carrola1/RasPi_NFC_Audio_PCB/RasPi Zero Pic.jpg

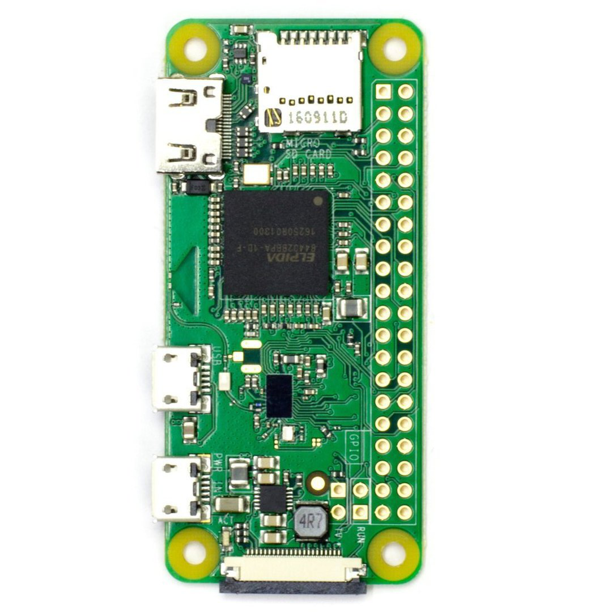
RasPi Zero Pic.jpg
