carrola1/RasPi_NFC_Audio_PCB/pcbway/IMG_20200323_132457.jpg

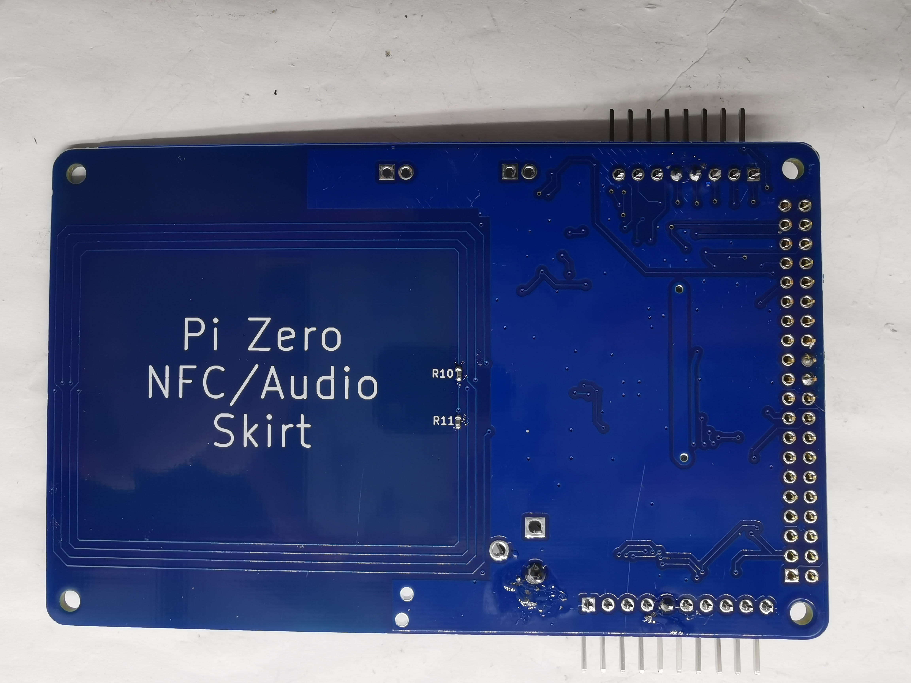
pcbway/IMG_20200323_132457.jpg
