carrola1/RasPi_NFC_Audio_PCB/pcbway/Quote_W48854ASR9-1set-RasPi_NFC_Audio_BOM 2020-2-8.xlsx

1sets | total | remark | Item | Ref Des | Qty | Part # | Value/Description | Package | Type | Instructions
$1.050 | $2.10 |  | 1 | C1, C28 | 2 | Basic | 100u 6.3V +/-20% | 1206_C | SMD
$0.525 | $3.15 |  | 2 | C3, C8, C9, C16, C26, C27 | 6 | Basic | 10u 6.3V +/-20% | 0603_C | SMD
$0.525 | $1.05 |  | 3 | C6, C7 | 2 | Basic | 33p 50V +/-5% | 0603_C | SMD
$0.525 | $0.53 |  | 4 | C17 | 1 | Basic | 1000p 50V +/-5% | 0603_C | SMD
$0.525 | $1.05 |  | 5 | C18, C21 | 2 | Basic | 22p 100V +/-5% | 0603_C | SMD
$0.525 | $1.05 |  | 6 | C19, C20 | 2 | Basic | 220p 50V +/-5% | 0603_C | SMD
$0.525 | $1.05 |  | 7 | C22, C23 | 2 | Basic | 100p 50V +/-5% | 0603_C | SMD
$0.525 | $4.73 |  | 8 | C10-C15, C24, C25, C29 | 9 | Basic | 0.1u 50V +/-10% | 0603_C | SMD
$1.575 | $1.57 | 5-7work days | 9 | J1 | 1 | PJ-102AH | Barrel_Jack_Switch | Connector_BarrelJack_Horizontal | THT
$1.050 | $1.05 |  | 10 | J2 | 1 | M20-7831046 | Conn_02x20_Odd_Even | Connector_PinHeader_2.54mm_2x20_Vertical | THT
$0.315 | $0.32 |  | 11 | J3 | 1 | M20-9960845 | Conn_01x08 | Connector_PinHeader_2.54mm_1x08_Horizontal | THT
 | $0.00 | no need offer | 12 | J4, J5 | 2 | DO NOT POPULATE | Screw_Terminal_01x02 | TerminalBlock_1x02_P2.54mm_Horizontal | THT
$0.315 | $0.32 |  | 13 | J6 | 1 | 68016-210HLF | Conn_01x10 | Connector_PinHeader_2.54mm_1x10_Horizontal | THT
$1.260 | $2.52 | 5-7work days | 14 | L1, L2 | 2 | MLJ1608WR56JT000 | 560n | 0603_L | SMD
$0.525 | $2.10 |  | 15 | Q1-Q4 | 4 | DMG1012T-7 | MOSFET | SOT-523 | SMD
 | $0.00 | no need offer | 16 | R1, R2 | 2 | DO NOT POPULATE | 0 | 0603_R | SMD | DO NOT POPULATE
$0.315 | $0.95 | 0R | 17 | R18, R19, R30 | 3 | Basic | 0 | 0603_R | SMD
 | $0.00 | no need offer | 18 | R20 | 1 | DO NOT POPULATE | 10k 1% | 0603_R | SMD | DO NOT POPULATE
$0.315 | $2.83 |  | 19 | R3-R5, R21-R23, R28, R29, R31 | 9 | Basic | 10k 1% | 0603_R | SMD
$0.315 | $0.32 |  | 20 | R6 | 1 | Basic | 1k 1% | 0603_R | SMD
$0.315 | $0.32 |  | 21 | R7 | 1 | Basic | 1.6k 1% | 0603_R | SMD
$0.315 | $0.63 | 1.5R | 22 | R8, R9 | 2 | Basic | 1.5 1% | 0603_R | SMD
$0.315 | $0.63 | 0R | 23 | R10, R11 | 2 | Basic | 0 | 0402_R | SMD
 | $0.00 | no need offer | 24 | R12-R15 | 4 | DO NOT POPULATE | 100k 1% | 0603_R | SMD | DO NOT POPULATE
$0.315 | $0.63 |  | 25 | R16, R17 | 2 | Basic | 1M 1% | 0603_R | SMD
$0.315 | $1.26 | 121R | 26 | R24-R27 | 4 | Basic | 121 1% | 0603_R | SMD
 | $0.00 | no need offer | 27 | TP1, TP2, TP5-TP8 | 6 | DO NOT POPULATE | TestPoint | Pad | SMD | DO NOT POPULATE
$15.225 | $15.22 | 5-7work days | 28 | U2 | 1 | PN5321A3HN/C106,55 | NFC Transceiver | HVQFN40-6X6 | SMD | Align pin 1 to dot on PCB
$3.990 | $7.98 | 5-7work days | 29 | U3, U4 | 2 | MAX98357AETE+T | Audio Amplifier | QFN50P300X300X80-17N | SMD | Align pin 1 to dot on PCB
$1.890 | $1.89 | 5-7work days | 30 | U5 | 1 | FXL6408UMX | GPIO Expander | QFN40P260X180X55-16N | SMD | Align pin 1 to dot on PCB
$1.890 | $1.89 | 5-7work days | 31 | Y1 | 1 | 7M-27.120MAAJ-T | Oscillator | OSCCC500X320X105N | SMD | Align pin 1 to dot on PCB
 | $57.12
refer to：W48854ASR7-1set-RasPi_NFC_Audio_BOM 2020-1-18
