carrola1/RasPi_NFC_Audio_PCB/RasPi_NFC_Audio_KiCAD/RasPi_NFC_Audio_KiCAD.kicad_pcb

## KiCad design RasPi_NFC_Audio_KiCAD/RasPi_NFC_Audio_KiCAD.kicad_pcb (2020-01-21)

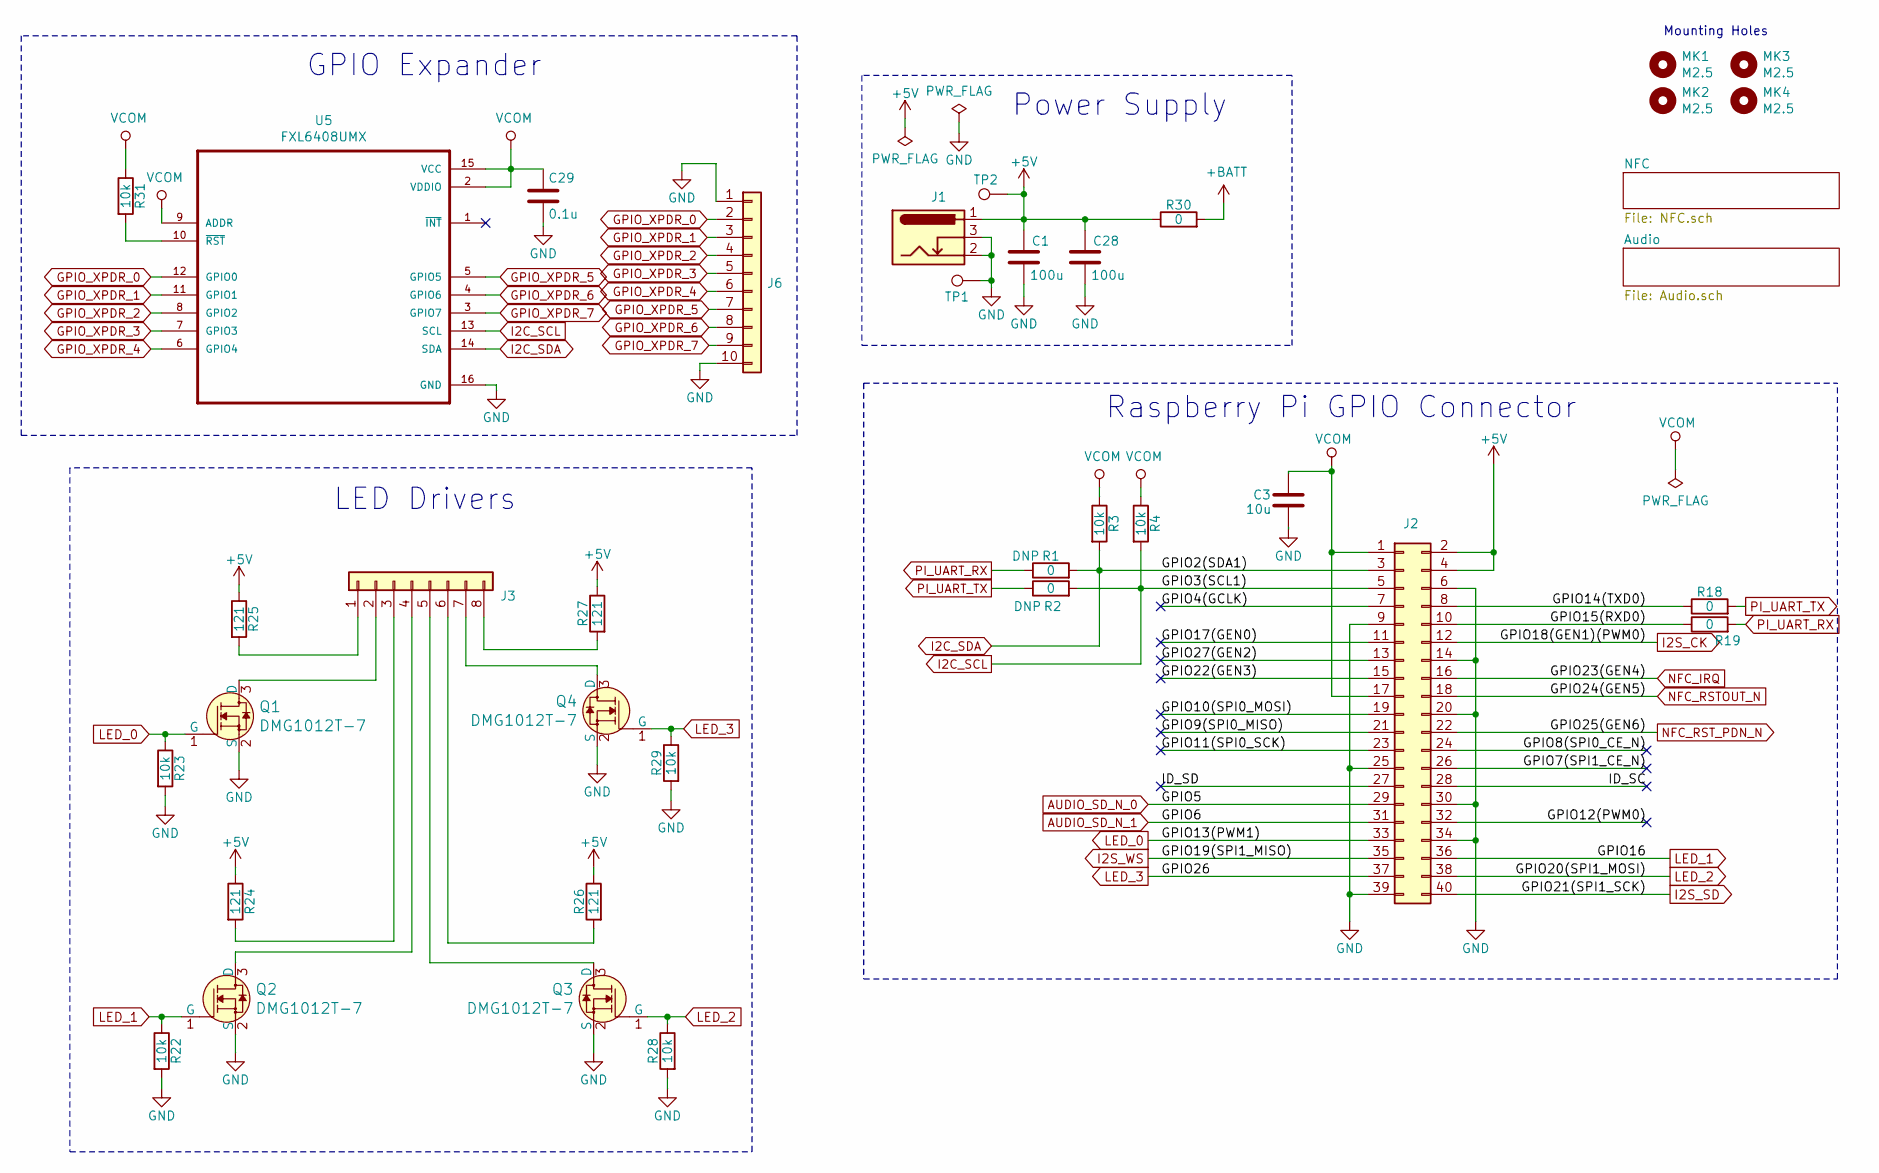
[picture p4: schematic RasPi_NFC_Audio_KiCAD.sch]

Parts:
C1, C28: 100u; C_1206_3216Metric_Pad1.42x1.75mm_HandSolder; Part # GRM31CD80J107ME39L; DigiKey 490-10525-1-ND
C3: 10u; C_0603_1608Metric_Pad1.05x0.95mm_HandSolder; Part # CL10A106MQ8NNNC; DigiKey 1276-1119-1-ND
C29: 0.1u; C_0603_1608Metric_Pad1.05x0.95mm_HandSolder; Part # CL10B104KB8NNNC; DigiKey 1276-1000-1-ND
J1: Barrel_Jack_Switch; BarrelJack_CUI_PJ-102AH_Horizontal; Part # PJ-102AH; DigiKey CP-102AH-ND
J2: Conn_02x20_Odd_Even; PinHeader_2x20_P2.54mm_Vertical; Part # M20-7831046; DigiKey 952-1837-ND
J3: Conn_01x08; PinHeader_1x08_P2.54mm_Horizontal; Part # M20-9960845; DigiKey 952-2249-ND
J6: Conn_01x10; PinHeader_1x10_P2.54mm_Horizontal; Part # 68016-210HLF; DigiKey 609-3322-ND
MK1, MK2, MK3, MK4: M2.5; MountingHole_2.7mm_M2.5
Q1, Q2, Q3, Q4: DMG1012T-7; SOT-523; MPN DMG1012T-7; Digi-Key_PN DMG1012T-7DICT-ND
R1, R2, R18, R19, R30: 0; R_0603_1608Metric_Pad1.05x0.95mm_HandSolder; Part # RC0603JR-070RL; DigiKey 311-0.0GRCT-ND
R3, R4, R22, R23, R28, R29, R31: 10k; R_0603_1608Metric_Pad1.05x0.95mm_HandSolder; Part # RNCP0603FTD10K0; DigiKey RNCP0603FTD10K0CT-ND
R24, R25, R26, R27: 121; R_0603_1608Metric_Pad1.05x0.95mm_HandSolder; Part # RMCF0603FT121R; DigiKey RMCF0603FT121RCT-ND
TP1, TP2: TestPoint; TestPoint_Keystone_5019_Minature
U5: FXL6408UMX; QFN40P260X180X55-16N; Part # FXL6408UMX; DigiKey FXL6408UMXCT-ND

Connections:
+5V: C1.1, C28.1, J1.1, J2.2, J2.4, R24.1, R25.1, R26.1, R27.1, R30.1, TP2.1; also elsewhere on the board
+BATT: R30.2; also elsewhere on the board
/GPIO4(GCLK): J2.7
/GPIO7(SPI1_CE_N): J2.26
/GPIO8(SPI0_CE_N): J2.24
/GPIO9(SPI0_MISO): J2.21
/GPIO10(SPI0_MOSI): J2.19
/GPIO11(SPI0_SCK): J2.23
/GPIO12(PWM0): J2.32
/GPIO14(TXD0): J2.8, R18.1
/GPIO15(RXD0): J2.10, R19.1
/GPIO17(GEN0): J2.11
/GPIO22(GEN3): J2.15
/GPIO27(GEN2): J2.13
/ID_SC: J2.28
/ID_SD: J2.27
AUDIO_SD_N_0: J2.29; also elsewhere on the board
AUDIO_SD_N_1: J2.31; also elsewhere on the board
GND: C1.2, C3.2, C28.2, C29.2, J1.2, J1.3, J2.6, J2.9, J2.14, J2.20, J2.25, J2.30, J2.34, J2.39, J6.1, J6.10, Q1.2 (S), Q2.2 (S), Q3.2 (S), Q4.2 (S), R22.2, R23.2, R28.2, R29.2, TP1.1, U5.16 (GND); also elsewhere on the board
GPIO_XPDR_0: J6.2, U5.12 (GPIO0)
GPIO_XPDR_1: J6.3, U5.11 (GPIO1)
GPIO_XPDR_2: J6.4, U5.8 (GPIO2)
GPIO_XPDR_3: J6.5, U5.7 (GPIO3)
GPIO_XPDR_4: J6.6, U5.6 (GPIO4)
GPIO_XPDR_5: J6.7, U5.5 (GPIO5)
GPIO_XPDR_6: J6.8, U5.4 (GPIO6)
GPIO_XPDR_7: J6.9, U5.3 (GPIO7)
I2C_SCL: J2.5, R2.2, R4.2, U5.13 (SCL)
I2C_SDA: J2.3, R1.2, R3.2, U5.14 (SDA)
I2S_CK: J2.12; also elsewhere on the board
I2S_SD: J2.40; also elsewhere on the board
I2S_WS: J2.35; also elsewhere on the board
LED_0: J2.33, Q1.1 (G), R23.1
LED_1: J2.36, Q2.1 (G), R22.1
LED_2: J2.38, Q3.1 (G), R28.1
LED_3: J2.37, Q4.1 (G), R29.1
NFC_IRQ: J2.16; also elsewhere on the board
NFC_RSTOUT_N: J2.18; also elsewhere on the board
NFC_RST_PDN_N: J2.22; also elsewhere on the board
unnamed: J3.1, R25.2
unnamed: J3.2, Q1.3 (D)
unnamed: J3.3, R24.2
unnamed: J3.4, Q2.3 (D)
unnamed: J3.5, Q3.3 (D)
unnamed: J3.6, R26.2
unnamed: J3.7, Q4.3 (D)
unnamed: J3.8, R27.2
unnamed: R31.2, U5.10 (~RST~)
PI_UART_RX: R1.1, R19.2; also elsewhere on the board
PI_UART_TX: R2.1, R18.2; also elsewhere on the board
VCOM: C3.1, C29.1, J2.1, J2.17, R3.1, R4.1, R31.1, U5.2 (VDDIO), U5.9 (ADDR), U5.15 (VCC); also elsewhere on the board

Notes on the sheet:
Mounting Holes
Power Supply
Raspberry Pi GPIO Connector
LED Drivers
GPIO Expander

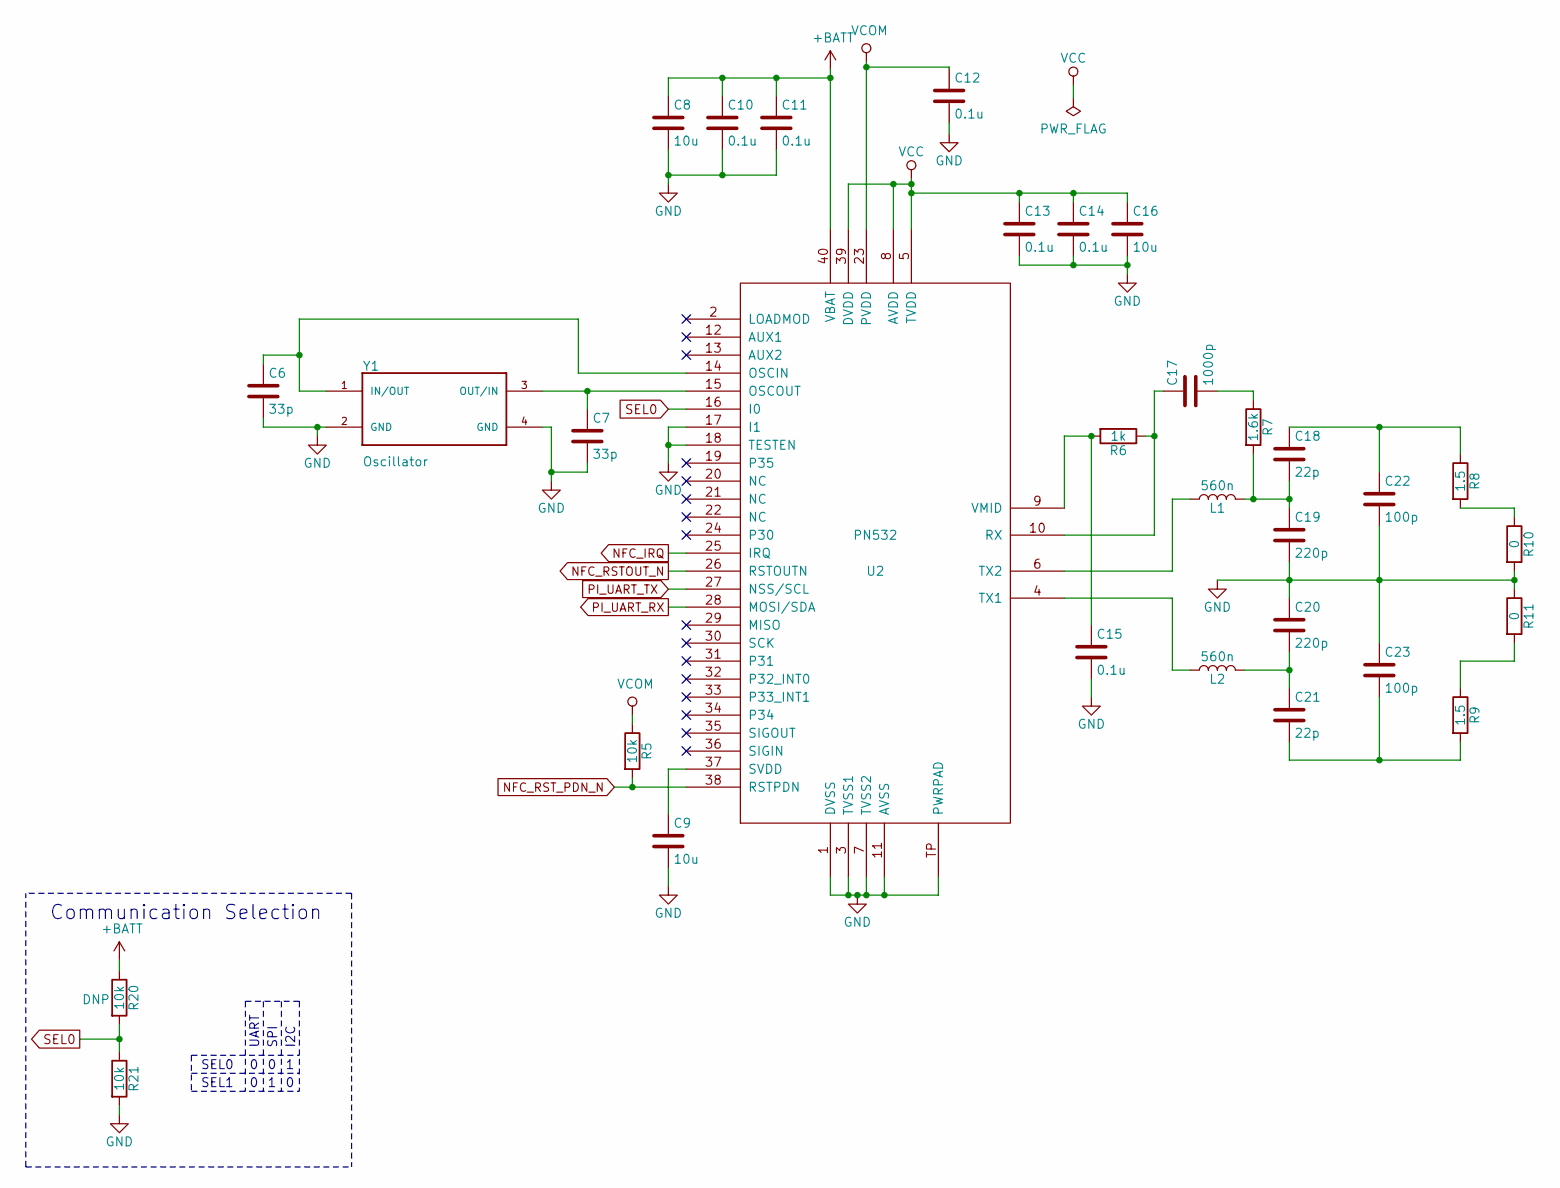
[picture p5: schematic NFC.sch]

Parts:
C6, C7: 33p; C_0603_1608Metric_Pad1.05x0.95mm_HandSolder; Part # C0603C330J1GACTU; DigiKey 399-7896-1-ND
C8, C9, C16: 10u; C_0603_1608Metric_Pad1.05x0.95mm_HandSolder; Part # CL10A106MQ8NNNC; DigiKey 1276-1119-1-ND
C10, C11, C12, C13, C14, C15: 0.1u; C_0603_1608Metric_Pad1.05x0.95mm_HandSolder; Part # CL10B104KB8NNNC; DigiKey 1276-1000-1-ND
C17: 1000p; C_0603_1608Metric_Pad1.05x0.95mm_HandSolder; Part # C0603C102J5RACTU; DigiKey 399-1083-1-ND
C18, C21: 22p; C_0603_1608Metric_Pad1.05x0.95mm_HandSolder; Part # C0603C220J1GACTU; DigiKey 399-7874-1-ND
C19, C20: 220p; C_0603_1608Metric_Pad1.05x0.95mm_HandSolder; Part # CC0603JRNPO9BN221; DigiKey 311-1073-1-ND
C22, C23: 100p; C_0603_1608Metric_Pad1.05x0.95mm_HandSolder; Part # CC0603JRNPO9BN101; DigiKey 311-1069-1-ND
L1, L2: 560n; L_0603_1608Metric_Pad1.05x0.95mm_HandSolder; Part # MLJ1608WR56JT000; DigiKey 445-174193-1-ND
R5, R20, R21: 10k; R_0603_1608Metric_Pad1.05x0.95mm_HandSolder; Part # RNCP0603FTD10K0; DigiKey RNCP0603FTD10K0CT-ND
R6: 1k; R_0603_1608Metric_Pad1.05x0.95mm_HandSolder; Part # RC0603JR-071KL; DigiKey 311-1.0KGRCT-ND
R7: 1.6k; R_0603_1608Metric_Pad1.05x0.95mm_HandSolder; Part # RC0603FR-071K6L; DigiKey 311-1.60KHRCT-ND
R8, R9: 1.5; R_0603_1608Metric_Pad1.05x0.95mm_HandSolder; Part # RMCF0603FT1R50; DigiKey RMCF0603FT1R50CT-ND
R10, R11: 0; R_0402_1005Metric; Part # RC1005J000CS; DigiKey 1276-3480-1-ND
U2: PN532; HVQFN40-6X6; Part # PN5321A3HN/C106,55; DigiKey 568-13228-ND
Y1: Oscillator; OSCCC500X320X105N; Part # 7M-27.120MAAJ-T; DigiKey 887-1424-1-ND

Connections:
+BATT: C8.1, C10.1, C11.1, R20.1, U2.40 (VBAT); also elsewhere on the board
GND: C6.2, C7.2, C8.2, C9.2, C10.2, C11.2, C12.2, C13.2, C14.2, C15.2, C16.2, C19.2, C20.1, C22.2, C23.1, R10.2, R11.1, R21.2, U2.1 (DVSS), U2.3 (TVSS1), U2.7 (TVSS2), U2.11 (AVSS), U2.17 (I1), U2.18 (TESTEN), U2.TP (PWRPAD), Y1.2 (GND), Y1.4 (GND); also elsewhere on the board
NFC_IRQ: U2.25 (IRQ); also elsewhere on the board
NFC_RSTOUT_N: U2.26 (RSTOUTN); also elsewhere on the board
NFC_RST_PDN_N: R5.2, U2.38 (RSTPDN); also elsewhere on the board
unnamed: C6.1, U2.14 (OSCIN), Y1.1 (IN/OUT)
unnamed: C7.1, U2.15 (OSCOUT), Y1.3 (OUT/IN)
unnamed: C9.1, U2.37 (SVDD)
unnamed: C15.1, R6.2, U2.9 (VMID)
unnamed: C17.1, R6.1, U2.10 (RX)
unnamed: C17.2, R7.1
unnamed: C18.1, C22.1, R8.1
unnamed: C18.2, C19.1, L1.2, R7.2
unnamed: C20.2, C21.1, L2.2
unnamed: C21.2, C23.2, R9.2
unnamed: L1.1, U2.6 (TX2)
unnamed: L2.1, U2.4 (TX1)
unnamed: R8.2, R10.1
unnamed: R9.1, R11.2
PI_UART_RX: U2.28 (MOSI/SDA); also elsewhere on the board
PI_UART_TX: U2.27 (NSS/SCL); also elsewhere on the board
SEL0: R20.2, R21.1, U2.16 (I0)
VCC: C13.1, C14.1, C16.1, U2.5 (TVDD), U2.8 (AVDD), U2.39 (DVDD)
VCOM: C12.1, R5.1, U2.23 (PVDD); also elsewhere on the board

Notes on the sheet:
SEL0
SEL1
UART
SPI
I2C
Communication Selection

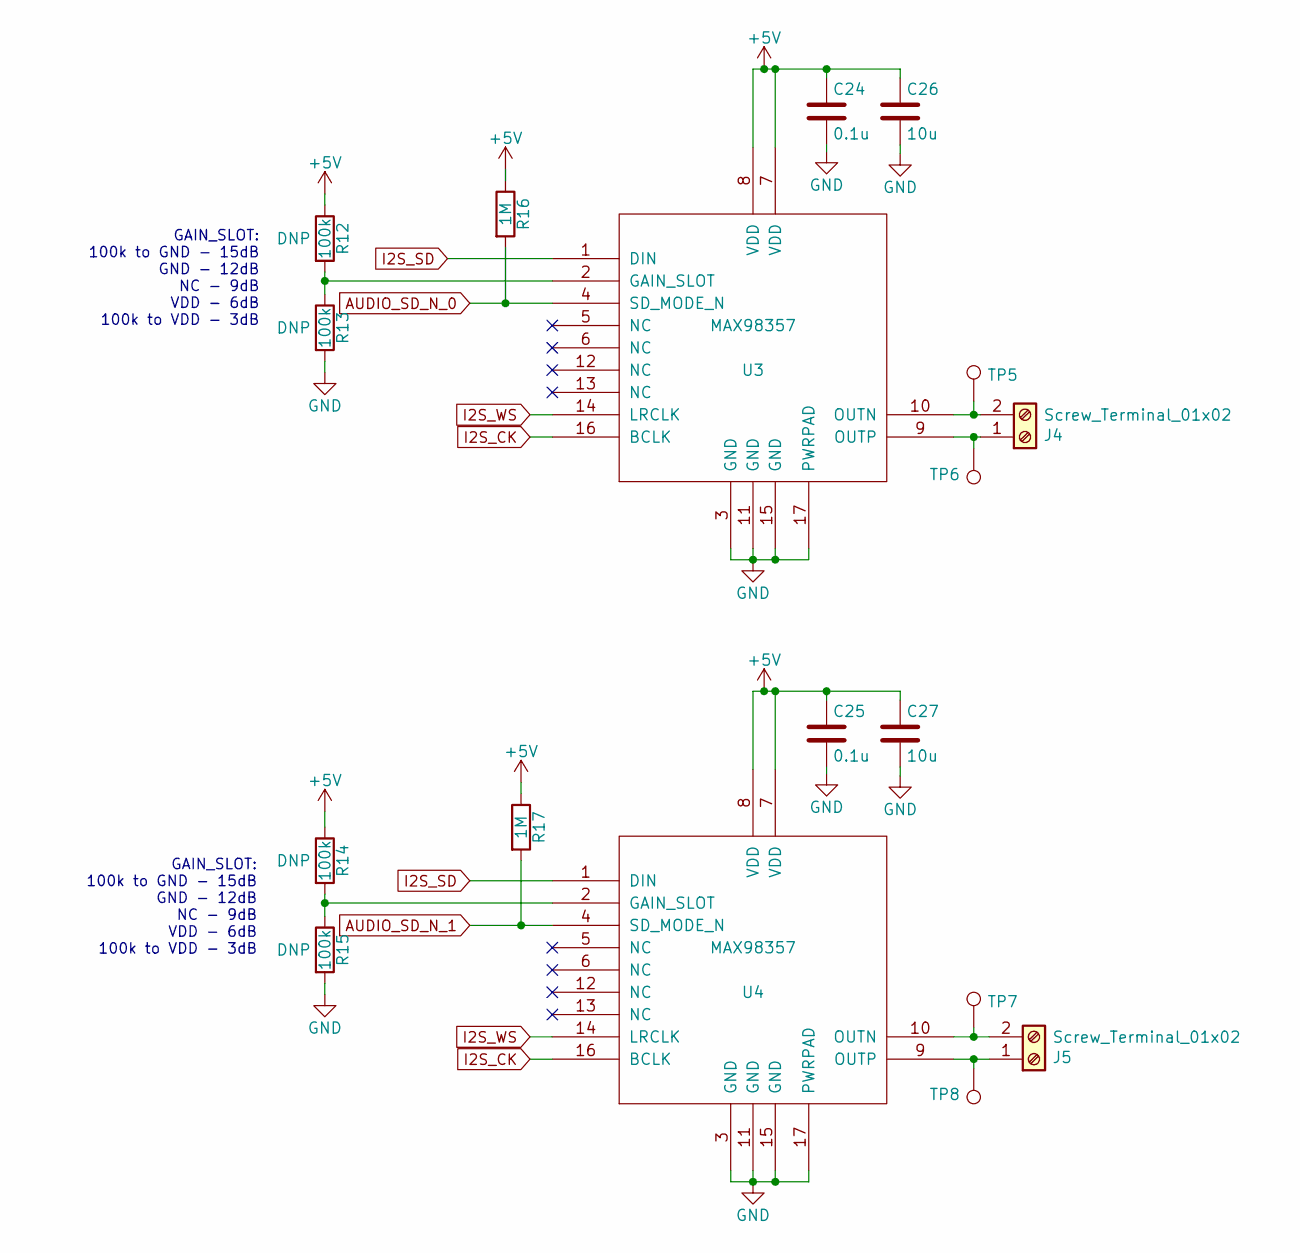
[picture p6: schematic Audio.sch]

Parts:
C24, C25: 0.1u; C_0603_1608Metric_Pad1.05x0.95mm_HandSolder; Part # CL10B104KB8NNNC; DigiKey 1276-1000-1-ND
C26, C27: 10u; C_0603_1608Metric_Pad1.05x0.95mm_HandSolder; Part # CL10A106MQ8NNNC; DigiKey 1276-1119-1-ND
J4, J5: Screw_Terminal_01x02; TerminalBlock_TE_282834-2_1x02_P2.54mm_Horizontal; Part # 282834-2; DigiKey A98333-ND
R12, R13, R14, R15: 100k; R_0603_1608Metric_Pad1.05x0.95mm_HandSolder; Part # RMCF0603FT100K; DigiKey RMCF0603FT100KCT-ND
R16, R17: 1M; R_0603_1608Metric_Pad1.05x0.95mm_HandSolder; Part # RC0603FR-071ML; DigiKey 311-1.00MHRCT-ND
TP5, TP6, TP7, TP8: TestPoint; TestPoint_Keystone_5019_Minature
U3, U4: MAX98357; QFN50P300X300X80-17N; Part # MAX98357AETE+T; DigiKey MAX98357AETE+TCT-ND

Connections:
+5V: C24.1, C25.1, C26.1, C27.1, R12.1, R14.1, R16.1, R17.1, U3.7 (VDD), U3.8 (VDD), U4.7 (VDD), U4.8 (VDD); also elsewhere on the board
AUDIO_SD_N_0: R16.2, U3.4 (SD_MODE_N); also elsewhere on the board
AUDIO_SD_N_1: R17.2, U4.4 (SD_MODE_N); also elsewhere on the board
GND: C24.2, C25.2, C26.2, C27.2, R13.2, R15.2, U3.3 (GND), U3.11 (GND), U3.15 (GND), U3.17 (PWRPAD), U4.3 (GND), U4.11 (GND), U4.15 (GND), U4.17 (PWRPAD); also elsewhere on the board
I2S_CK: U3.16 (BCLK), U4.16 (BCLK); also elsewhere on the board
I2S_SD: U3.1 (DIN), U4.1 (DIN); also elsewhere on the board
I2S_WS: U3.14 (LRCLK), U4.14 (LRCLK); also elsewhere on the board
unnamed: J4.1, TP6.1, U3.9 (OUTP)
unnamed: J4.2, TP5.1, U3.10 (OUTN)
unnamed: J5.1, TP8.1, U4.9 (OUTP)
unnamed: J5.2, TP7.1, U4.10 (OUTN)
unnamed: R12.2, R13.1, U3.2 (GAIN_SLOT)
unnamed: R14.2, R15.1, U4.2 (GAIN_SLOT)

Notes on the sheet:
GAIN_SLOT: 100k to GND - 15dB GND - 12dB NC - 9dB VDD - 6dB 100k to VDD - 3dB

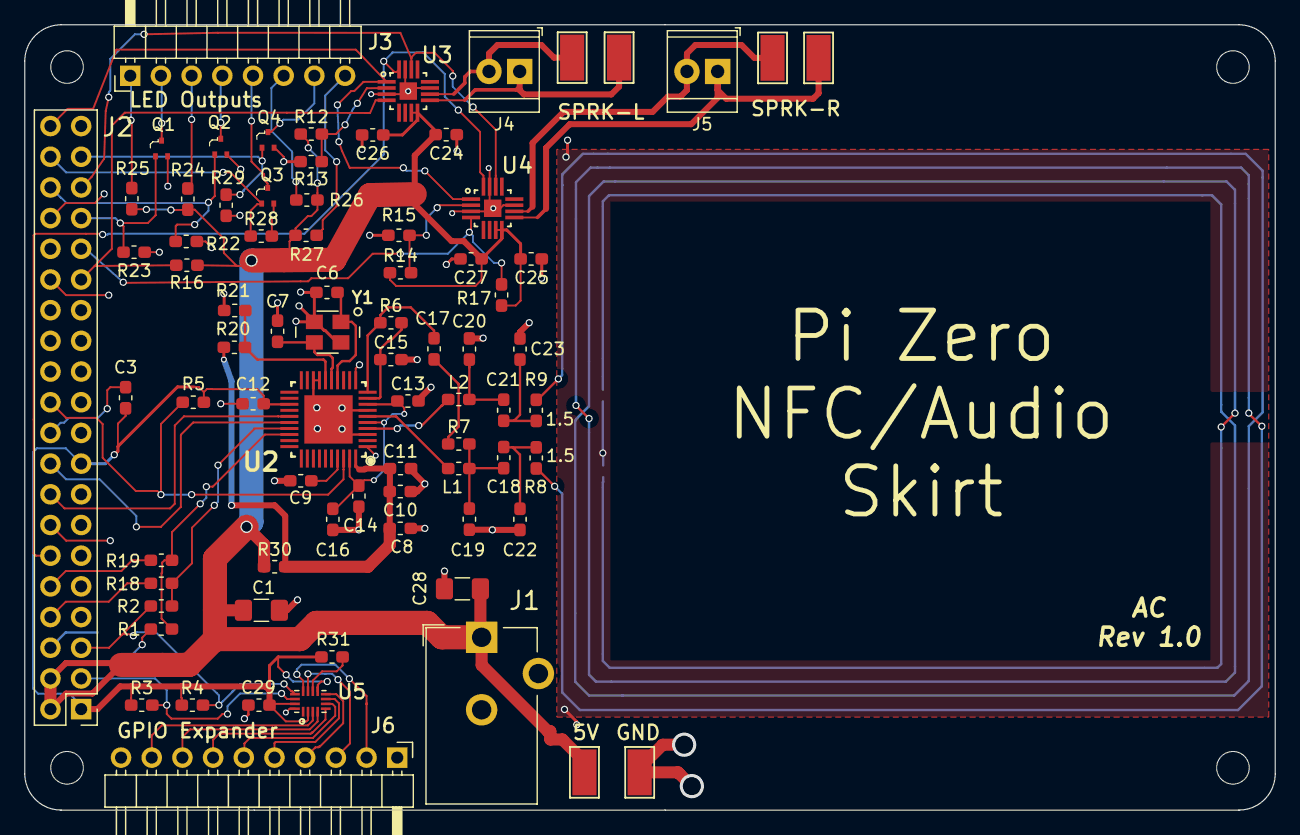
[picture p7: board RasPi_NFC_Audio_KiCAD.kicad_pcb from above]

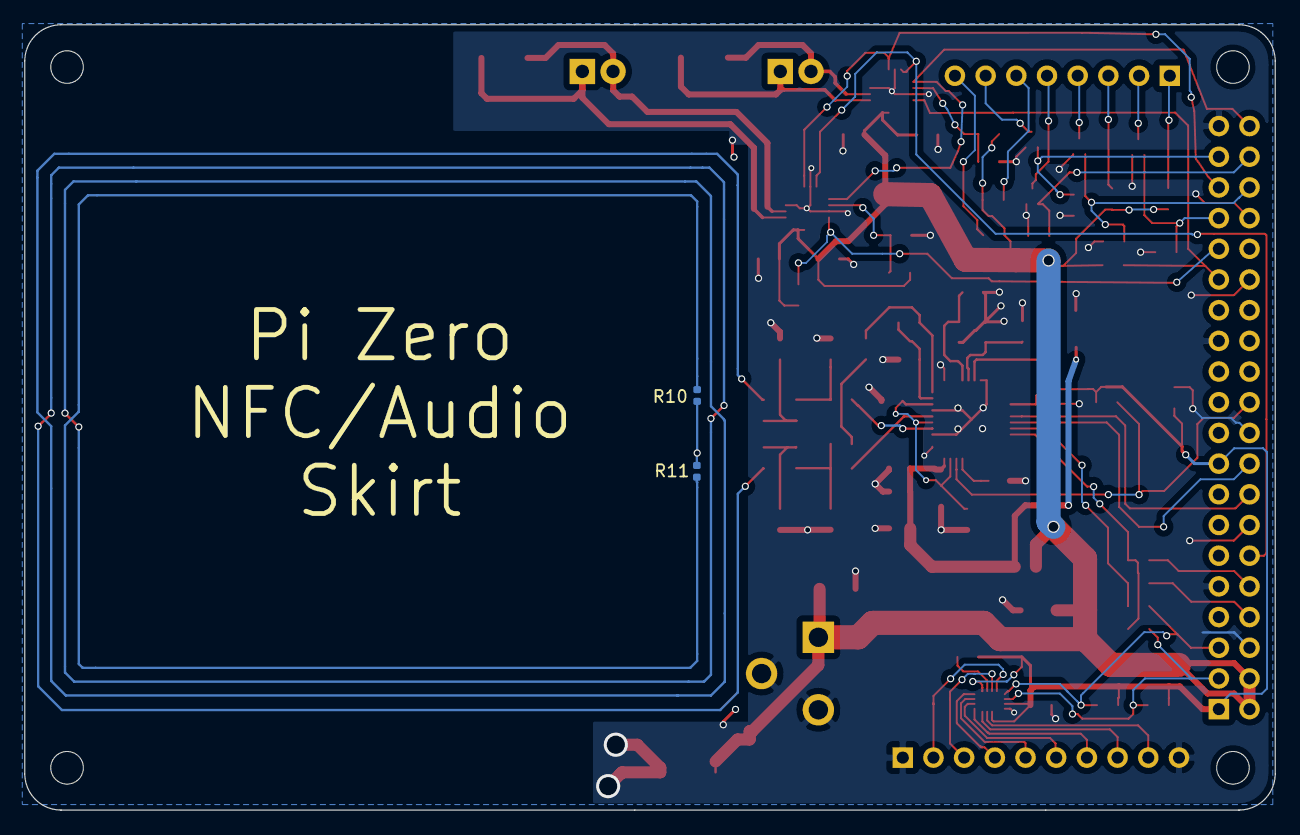
[picture p8: board RasPi_NFC_Audio_KiCAD.kicad_pcb from below]

Board: 2 copper layers, 103.5 x 65.0 mm, 84 parts (2 on the bottom side), 61 nets.
