carrola1/RasPi_NFC_Audio_PCB/(commit log)

2020-01-11 Added protocol selection jumpers
    [NFC.sch]
2020-01-11 Schematic update
    [Audio.sch, NFC.sch, RasPi_NFC_Audio_KiCAD.sch]
2020-01-12 Schematic Updates
    [Audio.sch, NFC.sch, RasPi_NFC_Audio_KiCAD.sch]
2020-01-12 Schematic changes
    [NFC.sch]
2020-01-14 Startednfootprint assignment
    [Audio.sch, NFC.sch, RasPi_NFC_Audio_KiCAD.sch]
2020-01-14 Layout started
    [Audio.sch, NFC.sch, RasPi_NFC_Audio_BOM.csv, RasPi_NFC_Audio_BOM.xlsx, RasPi_NFC_Audio_KiCAD.sch]
2020-01-15 Layout updates
    [RasPi_NFC_Audio_KiCAD.kicad_pcb]
2020-01-17 Gerbers and BOM generated
    [RasPi_NFC_Audio_BOM.xlsx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]
2020-01-20 Added GPIO expander to schematic
    [NFC.sch, RasPi_NFC_Audio_BOM.xlsx, RasPi_NFC_Audio_KiCAD.kicad_pcb, RasPi_NFC_Audio_KiCAD.sch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]
2020-01-20 Updated layout for GPIO expander
    [Audio.sch, NFC.sch, RasPi_NFC_Audio_KiCAD.kicad_pcb, RasPi_NFC_Audio_KiCAD.sch]
2020-01-21 Updated BOM
    [RasPi_NFC_Audio_BOM.xlsx, RasPi_NFC_Audio_KiCAD.kicad_pcb]
2020-01-21 Gerbers generated
    [RasPi_NFC_Audio_BOM.csv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]
2020-02-10 Updated centroid files
    [RasPi_NFC_Audio_KiCAD-bottom-pos.csv, RasPi_NFC_Audio_KiCAD-top-pos.csv]
2020-04-02 Adding PCBWay files
    [Quote_W48854ASR9-1set-RasPi_NFC_Audio_BOM 2020-2-8.xlsx]
